Gholab/R2D2/README.md

# R2D2
Hand Gesture Controlled Robot (R2D2)
