Gholab/R2D2/rapportValentine/RapportSéance7.docx

Fantozzi

Valentine G3

RAPPORT SEANCE 7 :

Durant cette séance, nous souhaitions avancer sur la construction du robot.

Avec Hajar, nous avons dû limer la pièce qui permet d’assembler la tête du R2D2 avec son corps car celle-ci ne s’emboitait pas correctement.

Après avoir découpé au laser les étages qui permettront de mieux organiser les composants électroniques à l’intérieur du robot, nous les avons assemblés à l’aide d’entretoises. Nous avons donc cherché des entretoises de même taille ainsi que des vis permettant leur fixation. Cependant le montage des étages à l’intérieur du corps du robot nous a permis de nous rendre compte qu’il faudra retoucher le dernier étage afin qu’il ne gêne pas l’emboitement des bras sur le corps.

Ensuite, on a décidé d’ajouter un interrupteur afin de couper l’alimentation de la carte Arduino quand on ne souhaite pas utiliser le robot.

Puis je me suis occupée de l’aspect esthétique du robot afin qu’il ressemble davantage au R2D2 de la saga Star Wars. Avant de peindre le robot en blanc, il a fallu mettre du scotch sur certaines parties afin qu’elles restent grises. Puis j’ai bombé le corps du robot. J’ai fait attention de vaporiser des couches fines de peinture pour éviter le risque de coulures. Il faudra cependant repasser une couche de peinture pour intensifier la couleur.
