Gholab/R2D2/(commit log)

2022-12-14 Create Déroulement de projet
2023-04-17 Create Vidéo de Démonstration
